MarterLee/switch-power-supply-2017NUEDC/README.md

# switch power supply-2017NUEDC

### 全国大学生电子设计竞赛简介

> 全国大学生电子设计竞赛（National Undergraduate Electronics Design Contest）是[教育部](https://baike.baidu.com/item/教育部)和工业和信息化部共同发起的[大学生](https://baike.baidu.com/item/大学生/1444)学科竞赛之一，是面向大学生的群众性科技活动，目的在于推动高等学校促进信息与电子类学科课程体系和课程内容的改革。竞赛的特点是与高等学校相关专业的[课程体系](https://baike.baidu.com/item/课程体系/3465161)和课程内容改革密切结合，以推动其课程教学、教学改革和实验室建设工作。

竞赛主要分为7个方向：

1. 电源类
2. 信号源类
3. 高频无线电类
4. 放大器类
5. 仪器仪表类
6. 数据采集与处理类
7. 控制类

7个类别分开评测，评奖。其中各全国一等奖的获奖比例小于0.2%。在2017年NUEDC竞赛中，来自全国31个赛区的1,071所大学的43,341名学生参加了本届竞赛，赛制为4天3夜全封闭3人一组独立设计，制作。

## 17国赛电源赛题

### 任务

设计并制作由两个三相逆变器等组成的微电网模拟系统，其系统框图如图 1所示，负载为三相对称 Y 连接电阻负载。



### 要求
