MarterLee/switch-power-supply-2017NUEDC/Schematic/主板原理图.pdf

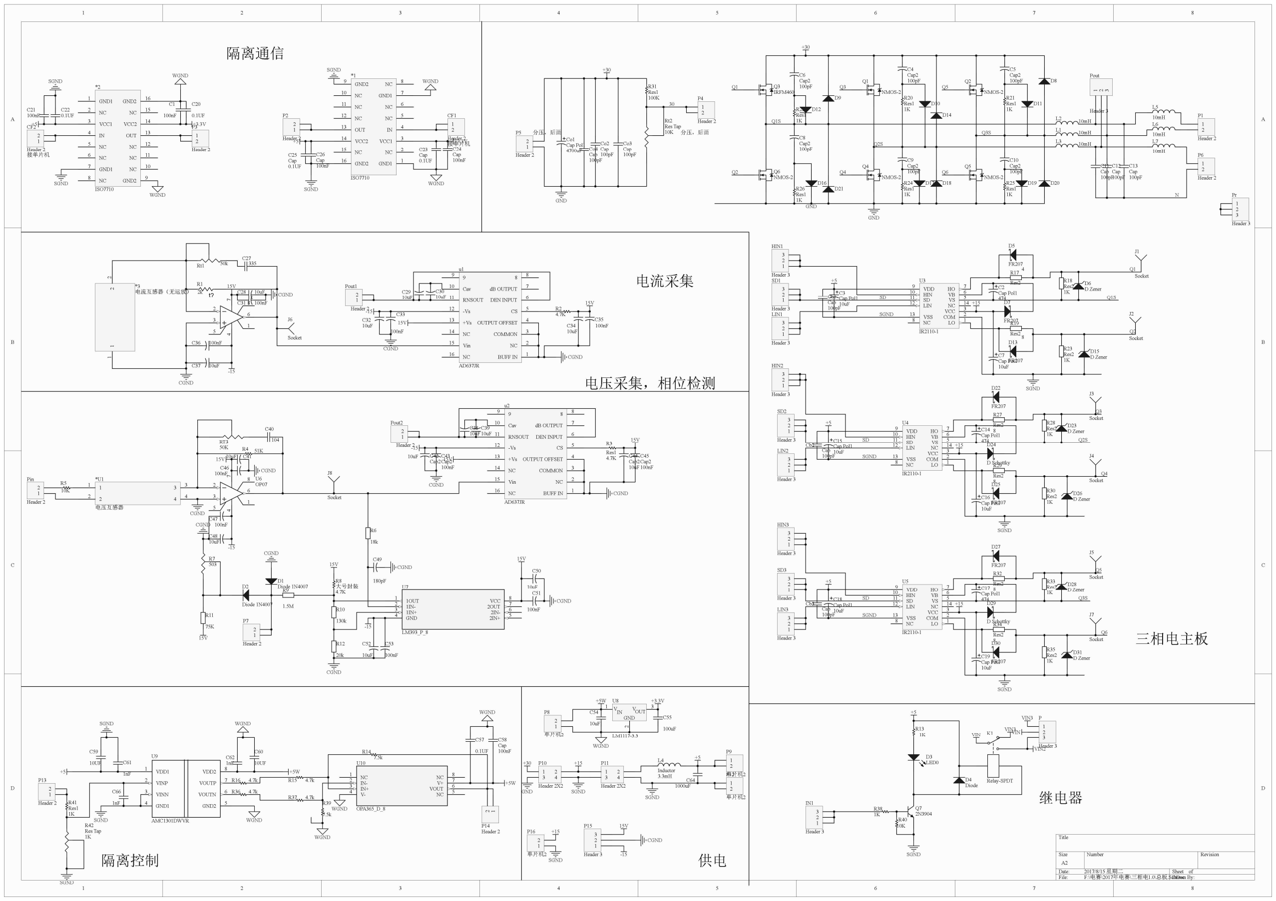
[picture p1: page 1]

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
Title
Size | Number | Revision
A2
Date: | 2017/8/15 星期二 | Sheet of
File: | F:\电赛\2017年电赛\三相电1.0\总板.SchDoc Drawn By:

LO 1

COM 2

VCC 3

VS 5

VB 6

HO 7

NC 8

VDD 9
HIN 10
SD 11
LIN 12
VSS 13

NC 14

U3

IR2110-1

474

C2
Cap Pol1

10uF

C7
Cap Pol1

D13
FR207

D7
FR207

D5
FR207
D6
D Zener

D15
D Zener

4
R17
Res2

8

R19
Res2

1K

R18
Res2

1K

R23
Res2

+15

LO 1

COM 2

VCC 3

VS 5

VB 6

HO 7

NC 8

VDD 9
HIN 10
SD 11
LIN 12
VSS 13

NC 14

U4

IR2110-1

474

C14
Cap Pol1

10uF

C16
Cap Pol1

D25
FR207

D24
D Schottky

D22
FR207
D23
D Zener

D26
D Zener

8

R27
Res2

8

R29
Res2

1K

R28
Res2

1K

R30
Res2

+15

SGND

SGND

SD

SD

SGND

SGND

Q3
IRFM460

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
HIN1

Header 3

1

2

3

SD1

Header 3

1

2

3

LIN1

Header 3

1

2

3

HIN2

Header 3

1

2

3

SD2

Header 3

1

2

3

LIN2

Header 3

10uF

C3
Cap Pol1

10uF

C15
Cap Pol1

GND

1K

R22
Res1

1K

R26
Res1

1K

R20
Res1

1K

R24
Res1

Q4
NMOS-2

Q6
NMOS-2

Q1
NMOS-2

+30

+5

+5

100pF

C6

Cap2 | 100pF C4
| Cap2

100pF

C9
Cap2

100pF

C8
Cap2

D12

D16 | D17 D10

J1

Socket

J2

Socket

J3

Socket

J4

Socket

100pF

Cb2
Cap

100pF

Cb1
Cap

LO 1

COM 2

VCC 3

VS 5

VB 6

HO 7

NC 8

VDD 9
HIN 10
SD 11
LIN 12
VSS 13

NC 14

U5

IR2110-1

474

C17
Cap Pol1

10uF

C19
Cap Pol1

D30
FR207

D29
D Schottky

D27
FR207
D28
D Zener

D31
D Zener

8

R32
Res2

8

R34
Res2

1K

R33
Res2

1K

R35
Res2

+15

SGND

SD
SGND

Q5

Q6

Q3S

1

2

3

HIN3

Header 3

1

2

3

SD3

Header 3

1

2

3

LIN3

Header 3

10uF

C18
Cap Pol1

+5

J5

Socket

J7

Socket

100pF

Cb3
Cap

Q5

Q6

Q3S

1K

R21
Res1

1K

R25
Res1

Q5
NMOS-2

Q2
NMOS-2

100pF

C5
Cap2

100pF

C10
Cap2
D19

D11

D9
D14

D8

D18 | D20
D21

10mH L1

10mH L2

10mH L3

100pF

C11
Cap
100pF

C12
Cap
100pF

C13
Cap

4700uF

Co1
Cap Pol1
100pF

Co2
Cap
100pF

Co3
Cap

100K

R31
Res1

GND

10K 分压，后画

Rt2
Res Tap

+30

1

2

P5

Header 2

分压，后画

30 1
2

P4

Header 2 | 1
| 2

P1

Header 2

1
2

P6

Header 2

2
3

6 4 7 1

8

5

15V

-15 ¹

1

2

2
*3
电流互感器（无运放） | t?

R1
2k

335

C27
50k Rt1

CGND

CGND

1

2

Pout1

Header 2
4.7K

R2

10uF

C30

BUFF IN 1

NC 2

COMMON 3

OUTPUT OFFSET 4

CS 5

DEN INPUT 6

dB OUTPUT 7 Cav 10
RNSOUT 11
-Vs 12
+Vs 13
NC 14
Vin 15
NC 16

8

8
9

9

u1

AD637JR

15V

-15

15V

100nF

C35

C36 100nF

C28 10uF CGND

100nF

C33

CGND

J6
Socket

C37 10uF

C31 100nF

10uF

10uF | C34

C32

10uF

C29

10K

R5

R4 51K

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
电压互感器

2
3

6 4 7 1

8

5

U6
OP07

CGND

104

C40

15V

-15

RT3
50K

-15

4.7K

R8

大号封装

15V

1

2

P7

Header 2

D2
Diode 1N4007 1.5M

R9

75K

R11

503

R7

15V

CGND

D1
Diode 1N4007

CGND

130k

R10

20k

R12

CGND

18k

R6

100nF

C46 CGND

10uF

C52

100nF

C47

J8

Socket

1OUT 1
1IN- 2
1IN+ 3
GND 4

2IN+ 5

2IN- 6

2OUT 7

VCC 8

U7

LM393_P_8

15V

100nF

C51

10uF

C50

CGND

100nF

C53

CGND

1

2

Pout2

Header 2
4.7K

R3
Res1

10uF

C39

BUFF IN 1

NC 2

COMMON 3

OUTPUT OFFSET 4

CS 5

DEN INPUT 6

dB OUTPUT 7 Cav 10
RNSOUT 11
-Vs 12
+Vs 13
NC 14
Vin 15
NC 16

8

8
9

9

u2

AD637JR

15V

-15

15V

100nF

C45
Cap2
100nF

C43
Cap2

CGND

10uF

C44
Cap2

10uF C42
Cap2

10uF

C38

180pF

C49
CGND

10uF

C48

10uF C41

VDD1 1
VINP 2
VINN 3
GND1 4 | GND2 5

VOUTN 6

VOUTP 7

VDD2 8

U9

AMC1301DWVR

NC 1
IN- 2
IN+ 3
V- 4 | NC 5

VOUT 6

V+ 7

NC 8

U10

OPA365_D_8

+5

10UF

C59

1nF

C61

1nF

C66 1

2

P13

Header 2

+5W

10UF

C60
1nF

C62

+5W
R36 4.7k
R16 | 4.7k 4.7k | R15
R37 4.7k
7.5k

R39

7.5k

R14 | 2

1
P14
Header 2

0.1UF

C57

SGND

SGND

WGND

WGND

WGND

100nF

C58
Cap

WGND

WGND

GND1 1
NC 2
VCC1 3
IN 4
NC 5
NC 6
GND1 7
NC 8

NC 10

NC 11

NC 12

OUT 13

VCC2 14

NC 15

GND2 16

GND2 9

*2

ISO7710

+5

0.1UF

C22

SGND

1

2

接单片机

CF2

Header 2

SGND

+3.3V

100nF

C1

WGND

WGND

1
2

P3

Header 2

100nF

C21
0.1UF

C20

GND1 1

NC 2

VCC1 3

IN 4

NC 5

NC 6

GND1 7

NC 8
NC 10
NC 11
NC 12
OUT 13
VCC2 14
NC 15
GND2 16

GND2 9

*1

ISO7710

0.1UF

C23
Cap

1
2

接单片机

CF1

Header 2

100nF

C26
Cap

1

2

P2

Header 2

100nF

C24
Cap
0.1UF

C25
Cap

SGND

SGND
WGND
+5 | +3.3V

WGND

1

2

P8

单片机2

+5W

WGND

1 3 2
V V
GND

IN OUT

U8

LM1117-3.3

10uF

C54
100uF

C55

+3.3V

1 2
3 4

P10

Header 2X2

1 2
3 4

P11

Header 2X2

+30

GND

+15

SGND

3.3mH

L4
Inductor

SGND

1
2

P9

单片机2
1
2

P12

单片机2

1000uF

C64

1

2

3

P15

Header 3

15V
CGND
-15

K1

Relay-SPDT

D3
LED0

1K

R13

+5

SGND

Q7
1K | 2N3904

R38
10K

R40 1

2

3

IN1

Header 3

VIN
VIN2

VIN3

N
1
2
3

Pr

Header 3

隔离通信

### 电流采集

### 电压采集，相位检测

隔离控制 | 供电

1

2

P16

单片机2

+15

SGND

### 三相电主板

继电器

D4
Diode

+5

100pF

Co4
Cap

1
2
3

P

Header 3

1

2

Pin

Header 2

1

2

3

Pout

Header 3
10mH

L5

10mH

L6

10mH

L7

1K

R41
Res1

1K

R42
Res Tap

SGND

VIN

VIN3
