MarterLee/switch-power-supply-2017NUEDC/Schematic/从板-原理图.pdf

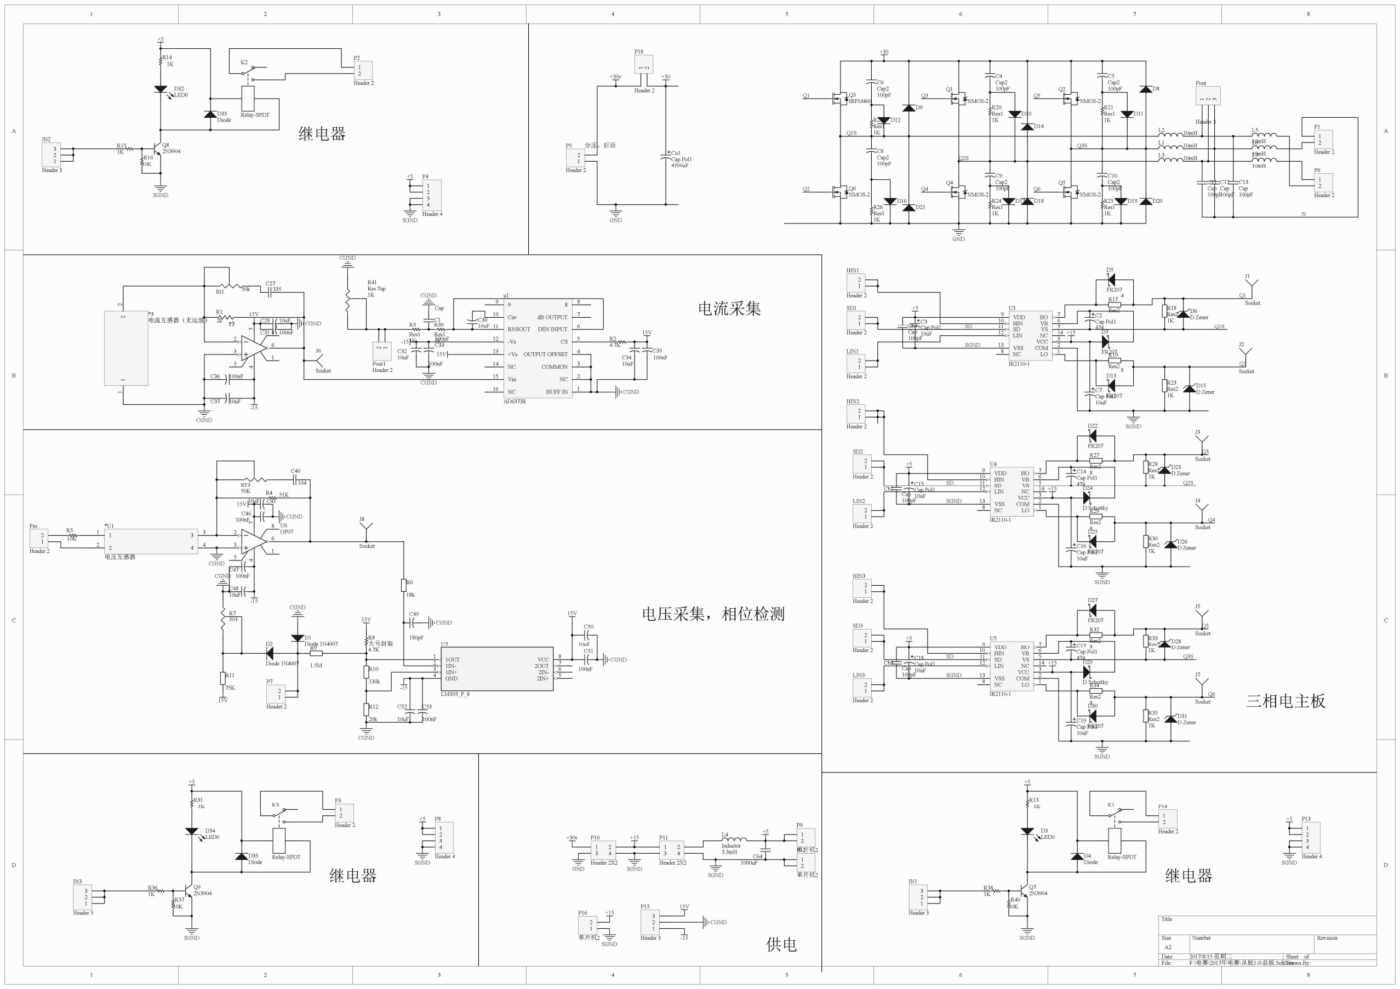
[picture p2: page 1]

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
Title
Size | Number | Revision
A2
Date: | 2017/8/15 星期二 | Sheet of
File: | F:\电赛\2017年电赛\从板1.0\总板.SchDoc Drawn By:

LO 1

COM 2

VCC 3

VS 5

VB 6

HO 7

NC 8

VDD 9
HIN 10
SD 11
LIN 12
VSS 13

NC 14

U3

IR2110-1

474

C2
Cap Pol1

10uF

C7
Cap Pol1

D13
FR207

D7
FR207

D5
FR207
D6
D Zener

D15
D Zener

4
R17
Res2

8

R19
Res2

1K

R18
Res2

1K

R23
Res2

+15

LO 1

COM 2

VCC 3

VS 5

VB 6

HO 7

NC 8

VDD 9
HIN 10
SD 11
LIN 12
VSS 13

NC 14

U4

IR2110-1

474

C14
Cap Pol1

10uF

C16
Cap Pol1

D25
FR207

D24
D Schottky

D22
FR207
D23
D Zener

D26
D Zener

8

R27
Res2

8

R29
Res2

1K

R28
Res2

1K

R30
Res2

+15

SGND

SGND

SD

SD

SGND

SGND

Q3
IRFM460

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
10uF

C3
Cap Pol1

10uF

C15
Cap Pol1

GND

1K

R22
Res1

1K

R26
Res1

1K

R20
Res1

1K

R24
Res1

Q4
NMOS-2

Q6
NMOS-2

Q1
NMOS-2

+30

+5

+5

100pF

C6

Cap2 | 100pF C4
| Cap2

100pF

C9
Cap2

100pF

C8
Cap2

D12

D16 | D17 D10

J1

Socket

J2

Socket

J3

Socket

J4

Socket

100pF

Cb2
Cap

100pF

Cb1
Cap

LO 1

COM 2

VCC 3

VS 5

VB 6

HO 7

NC 8

VDD 9
HIN 10
SD 11
LIN 12
VSS 13

NC 14

U5

IR2110-1

474

C17
Cap Pol1

10uF

C19
Cap Pol1

D30
FR207

D29
D Schottky

D27
FR207
D28
D Zener

D31
D Zener

8

R32
Res2

8

R34
Res2

1K

R33
Res2

1K

R35
Res2

+15

SGND

SD
SGND

Q5

Q6

Q3S
10uF

C18
Cap Pol1

+5

J5

Socket

J7

Socket

100pF

Cb3
Cap

Q5

Q6

Q3S

1K

R21
Res1

1K

R25
Res1

Q5
NMOS-2

Q2
NMOS-2

100pF

C5
Cap2

100pF

C10
Cap2
D19

D11

D9
D14

D8

D18 | D20
D21

10mH L1

10mH L2

10mH L3

100pF

C11
Cap
100pF

C12
Cap
100pF

C13
Cap

4700uF

Co1
Cap Pol1

GND

+30

1

2

P5

Header 2

分压，后画

1
2

P1

Header 2

1
2

P6

Header 2

2
3

6 4 7 1

8

5

15V

-15 ¹

1

2

2
*3
电流互感器（无运放） | t?

R1
2k

335

C27
50k Rt1

CGND

CGND ²

1
Pout1
Header 2

4.7K

R2

10uF

C30

BUFF IN 1

NC 2

COMMON 3

OUTPUT OFFSET 4

CS 5

DEN INPUT 6

dB OUTPUT 7 Cav 10
RNSOUT 11
-Vs 12
+Vs 13
NC 14
Vin 15
NC 16

8

8
9

9

u1

AD637JR

15V

-15

15V

100nF

C35

C36 100nF

C28 10uF CGND

100nF

C33

CGND

J6
Socket

C37 10uF

C31 100nF

10uF

10uF | C34

C32

10K

R5

R4 51K

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
电压互感器

2
3

6 4 7 1

8

5

U6
OP07

CGND

104

C40

15V

-15

RT3
50K

-15

4.7K

R8

大号封装

15V

1

2

P7

Header 2

D2
Diode 1N4007 1.5M

R9

75K

R11

503

R7

15V

CGND

D1
Diode 1N4007

CGND

130k

R10

20k

R12

CGND

18k

R6

100nF

C46 CGND

10uF

C52

100nF

C47

J8

Socket

1OUT 1
1IN- 2
1IN+ 3
GND 4

2IN+ 5

2IN- 6

2OUT 7

VCC 8

U7

LM393_P_8

15V

100nF

C51

10uF

C50

CGND

100nF

C53

180pF

C49
CGND

10uF

C48

10uF C41

1 2
3 4

P10

Header 2X2

1 2
3 4

P11

Header 2X2

+30v

GND

+15

SGND

3.3mH

L4
Inductor

SGND

1
2

P9

单片机2
1
2

P12

单片机2

1000uF

C64

1

2

3

P15

Header 3

15V
CGND
-15

K1

Relay-SPDT

D3
LED0

1K

R13

+5

SGND

Q7
1K | 2N3904

R38
10K

R40 1

2

3

IN1

Header 3

N

### 电流采集

### 电压采集，相位检测

供电

1

2

P16

单片机2

+15

SGND

### 三相电主板

继电器

D4
Diode

+5

1

2

Pin

Header 2

1

2

3

Pout

Header 3
10mH

L5

10mH

L6

10mH

L7

1

2

HIN1

Header 2

1

2

HIN2

Header 2

1

2

HIN3

Header 2

1

2

SD1

Header 2

1

2

SD2

Header 2

1

2

SD3

Header 2

1

2

LIN1

Header 2

1

2

LIN2

Header 2

1

2

LIN3

Header 2

K2

Relay-SPDT

D32
LED0

1K

R14

+5

SGND

Q8
1K | 2N3904

R15
10K

R16 1

2

3

IN2

Header 3

继电器

D33
Diode

K3

Relay-SPDT

D34
LED0

1K

R31

+5

SGND

Q9
1K | 2N3904

R36
10K

R37 1

2

3

IN3

Header 3

继电器

D35
Diode

+5

SGND

1
2

P2

Header 2

1
2

P14

Header 2

1
2

P3

Header 2

1

2

P18

Header 2

1
2
3
4

P8

Header 4

+5

SGND

1
2
3
4

P13

Header 4

+5

SGND

1
2
3
4

P4

Header 4

+30v

1K

R39
Res1
1K

R3
Res1

1K

R41
Res Tap

100pF

C1

Cap

CGND

CGND
