MarterLee/switch-power-supply-2017NUEDC/Doc/figure1.png

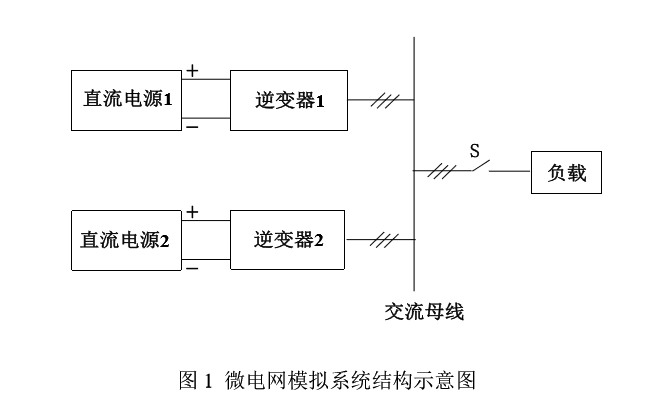
Doc/figure1.png
