MarterLee/switch-power-supply-2017NUEDC/Doc/(新版)MINI-STM32--原理图.pdf

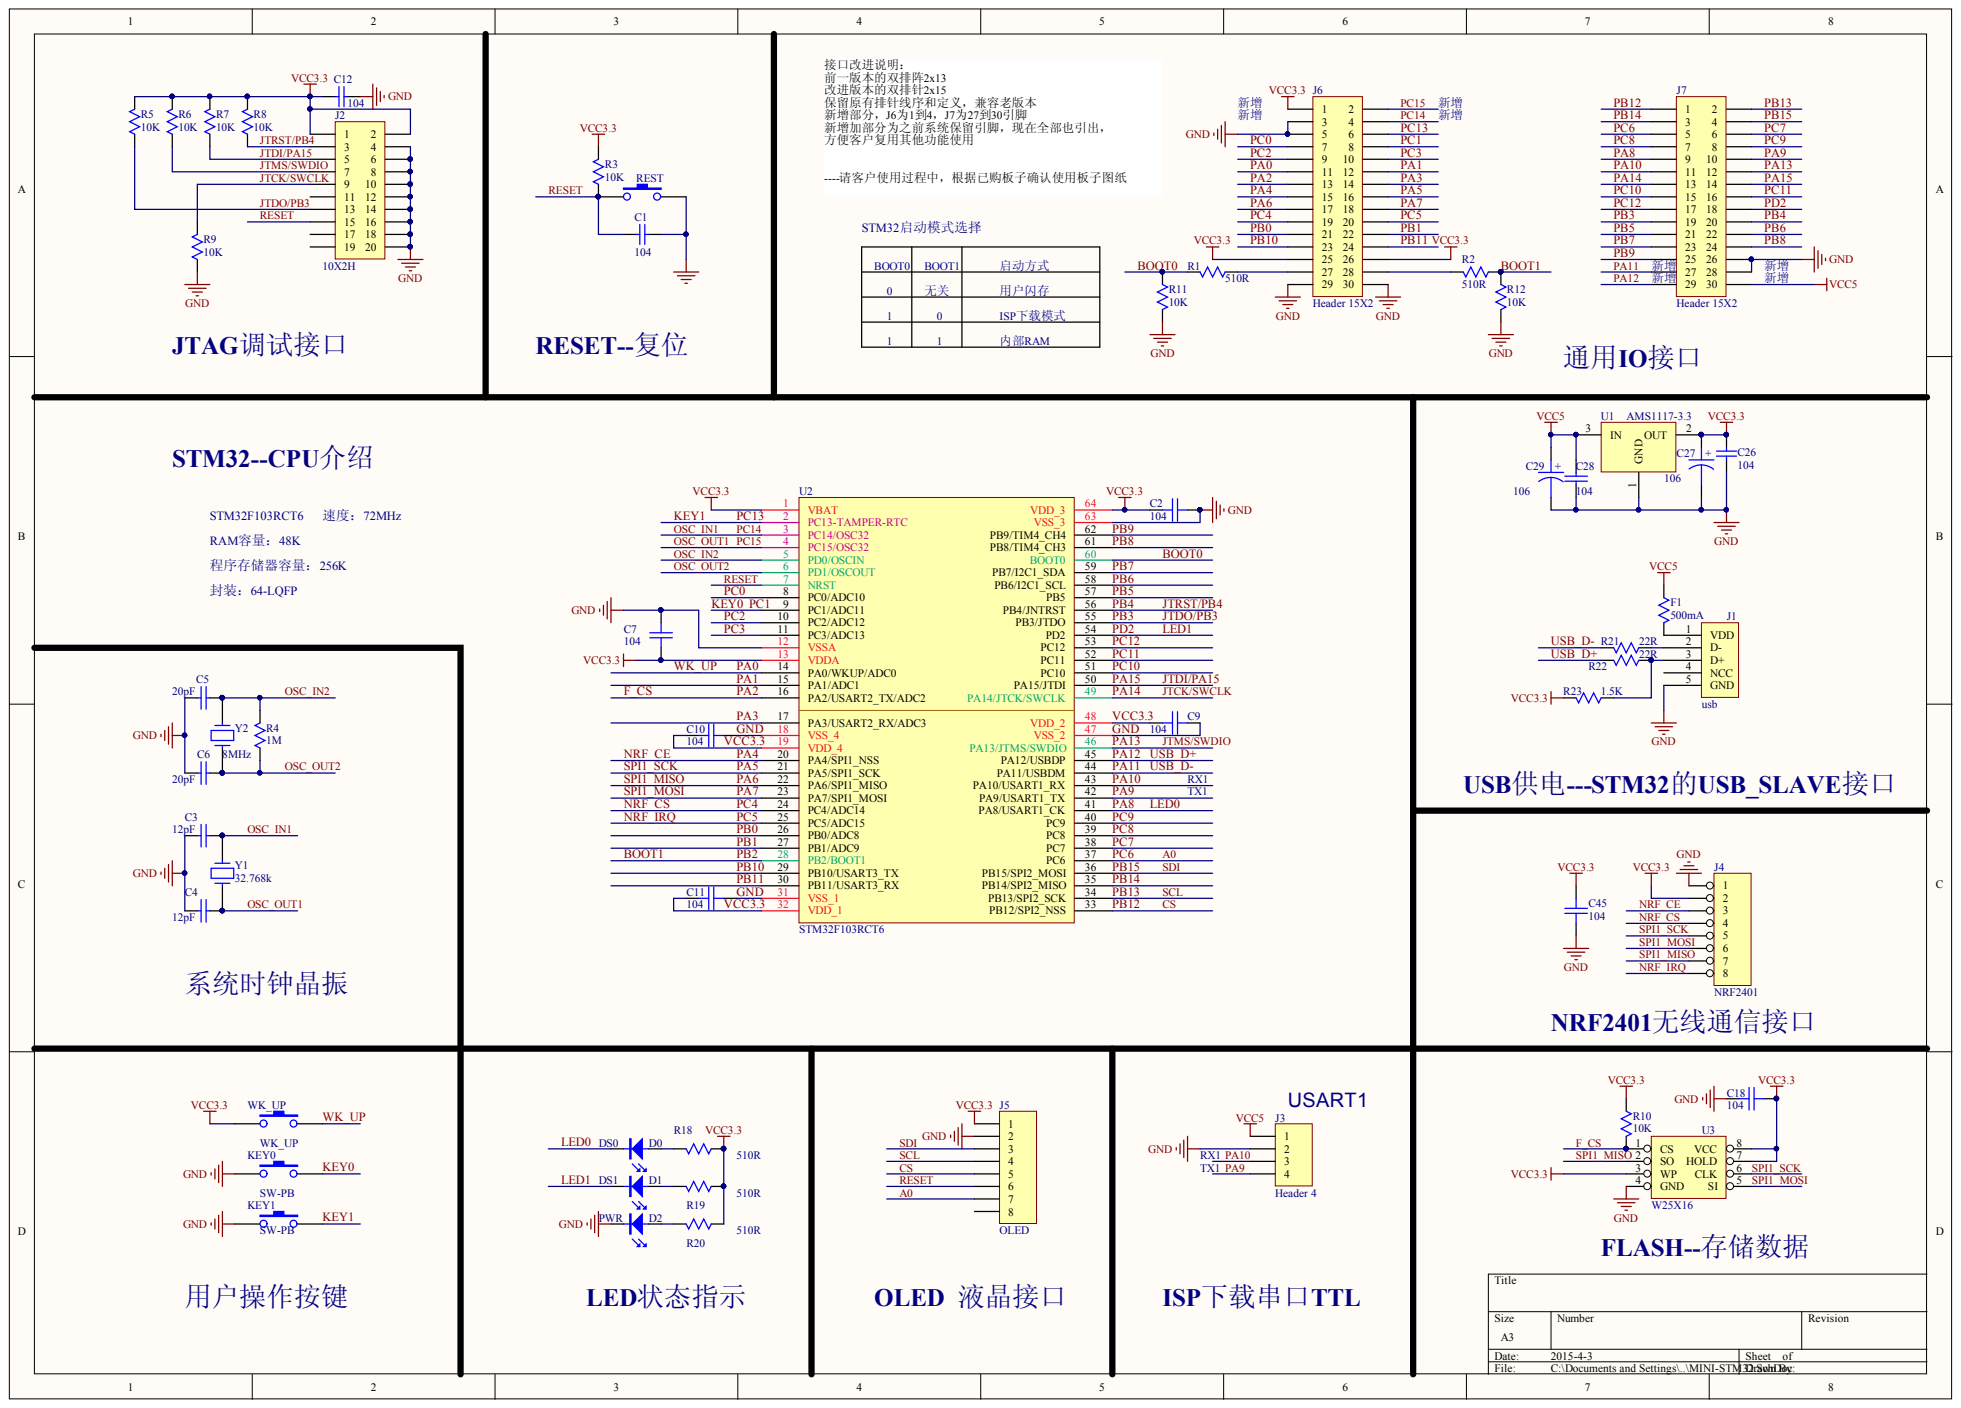
[picture p16: page 1]

JTDO/PB3
RESET

1 | 0 | ISP下载模式

1 | 1 | 内部RAM

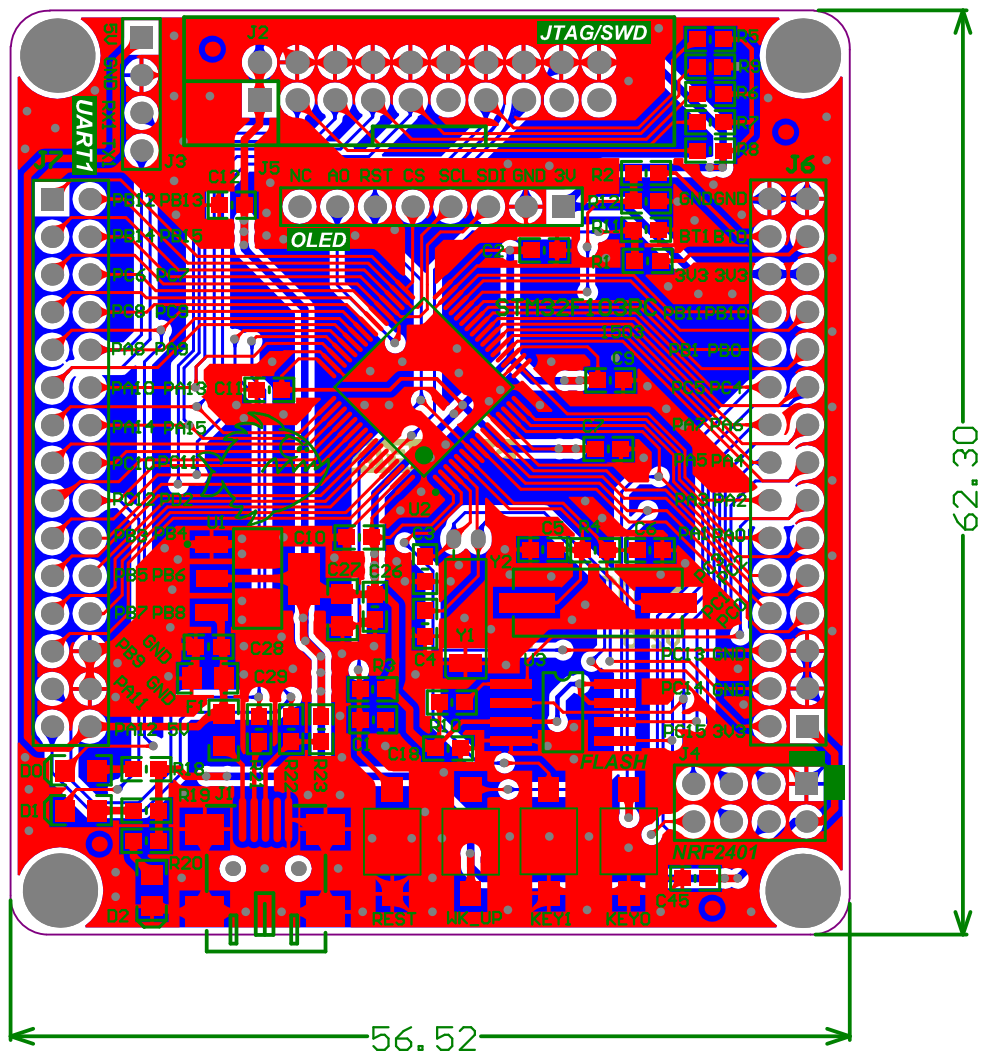
[picture p17: page 2]

Designator | Footprint | Quantity | Comment
C1, C12 | 0603C | 2 | 104
C2, C7, C9, C10, C11, C18, C26, C28, C45 | 0603J | 9 | 104
C3, C4 | 0603J | 2 | 12pF
C5, C6 | 0603J | 2 | 20pF
C27, C29 | RC0805 | 2 | 106
D0 | LED0805 | 1 | DS0
D1 | LED0805 | 1 | DS1
D2 | LED0805 | 1 | PWR
F1 | RC0805 | 1 | 500mA
J1 | mini_USB | 1 | usb
J2 | IDC20 | 1 | 10X2H
J3 | HDR1X4 | 1 | Header 4
J4 | HDR2X4 | 1 | NRF2401
J5 | HDR1X8 | 1 | OLED
J6, J7 | IDE15X2_2.54 | 2 | Header 15X2
KEY0, KEY1 | SW-SPST | 2 | SW-PB
R1, R2, R18, R19, R20 | 0603J | 5 | 510R
R3, R5, R6, R7, R8, R9, R10, R11, R12 | 0603J | 9 | 10K
R4 | 0603J | 1 | 1M
R21, R22 | 0603J | 2 | 22R
R23 | 0603J | 1 | 1.5K
REST | SW-SPST | 1
U1 | SOT223 | 1 | AMS1117-3.3
U2 | LQFP64 | 1 | STM32F103RCT6
U3 | SOIC8P | 1 | W25X16
WK_UP | SW-SPST | 1 | WK_UP
Y1 | 32.768k | 1 | 32.768k
Y2 | smt-xtal | 1 | 8MHz
