MarterLee/switch-power-supply-2017NUEDC/PCBs/主板.pdf

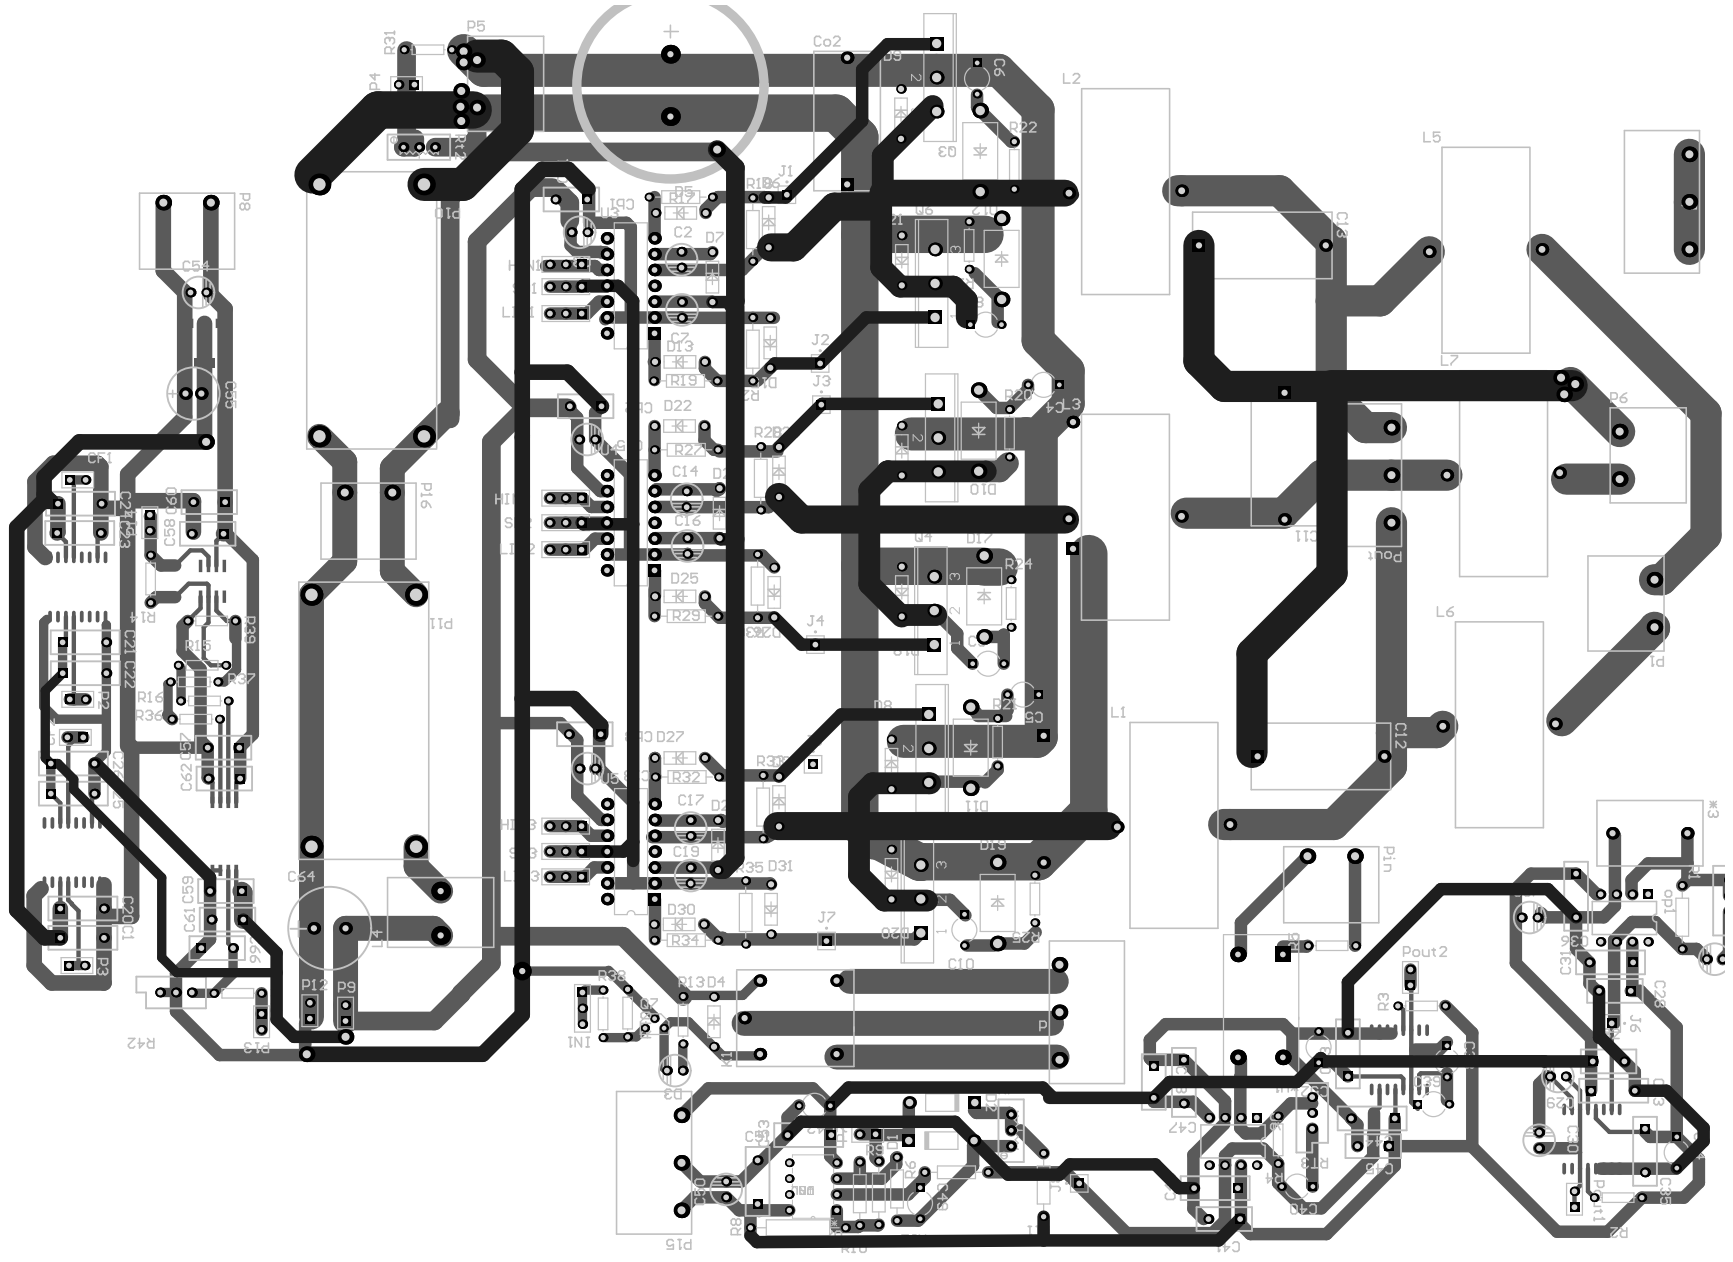
[picture p18: page 1]
