MarterLee/switch-power-supply-2017NUEDC/PCBs/从板.pdf

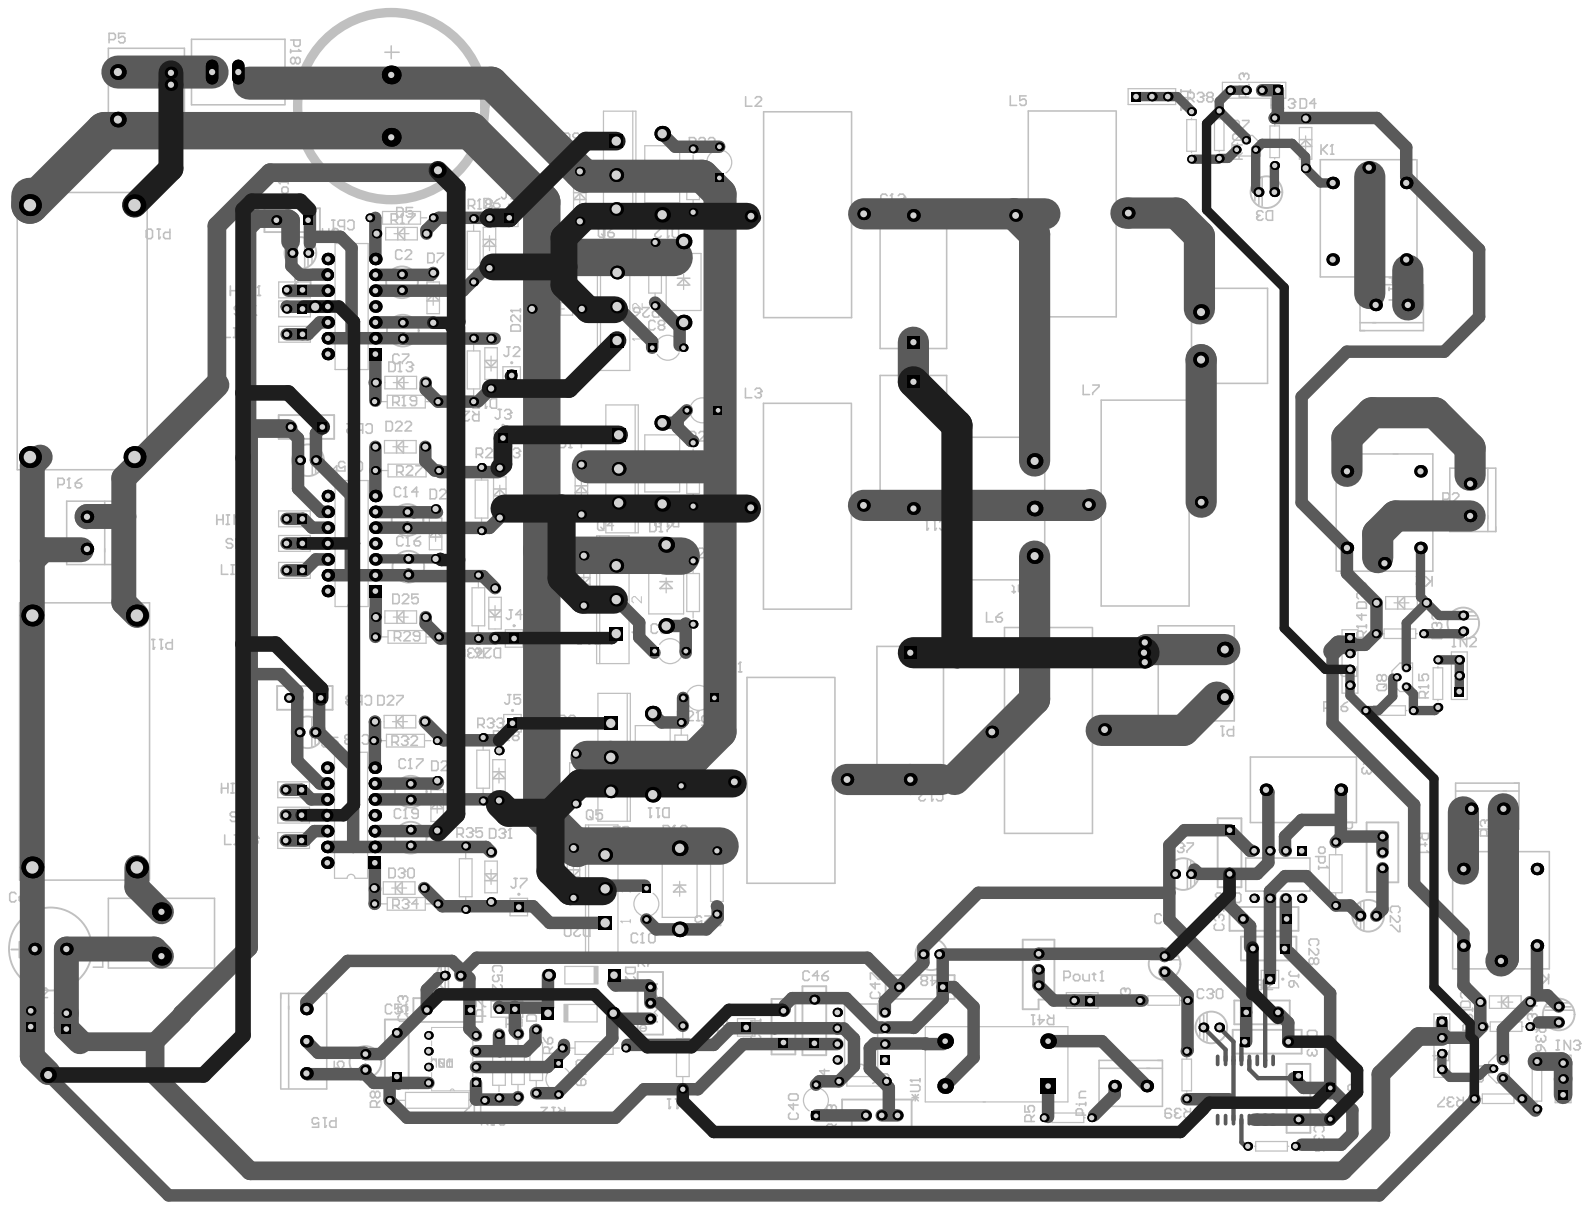
[picture p19: page 1]
