MarterLee/switch-power-supply-2017NUEDC/PCBs/从板1.0b.pdf

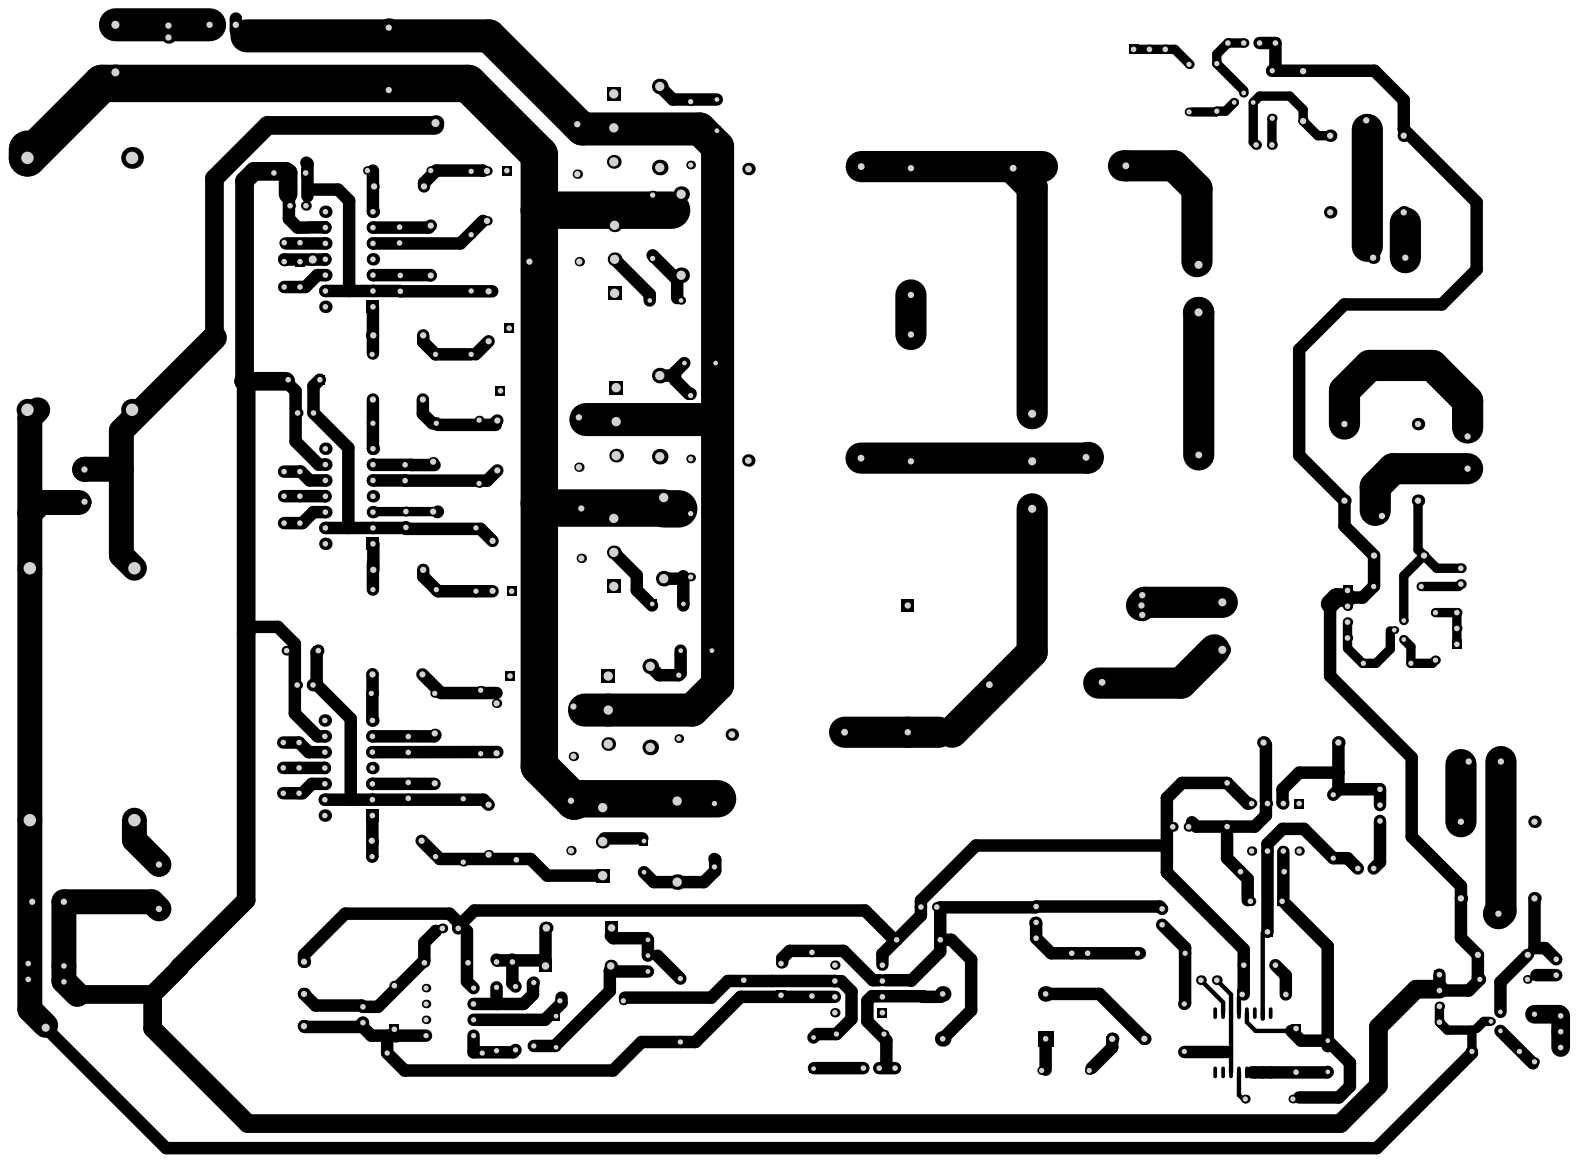
[picture p20: page 1]
