MarterLee/switch-power-supply-2017NUEDC/PCBs/从板1.0t.pdf

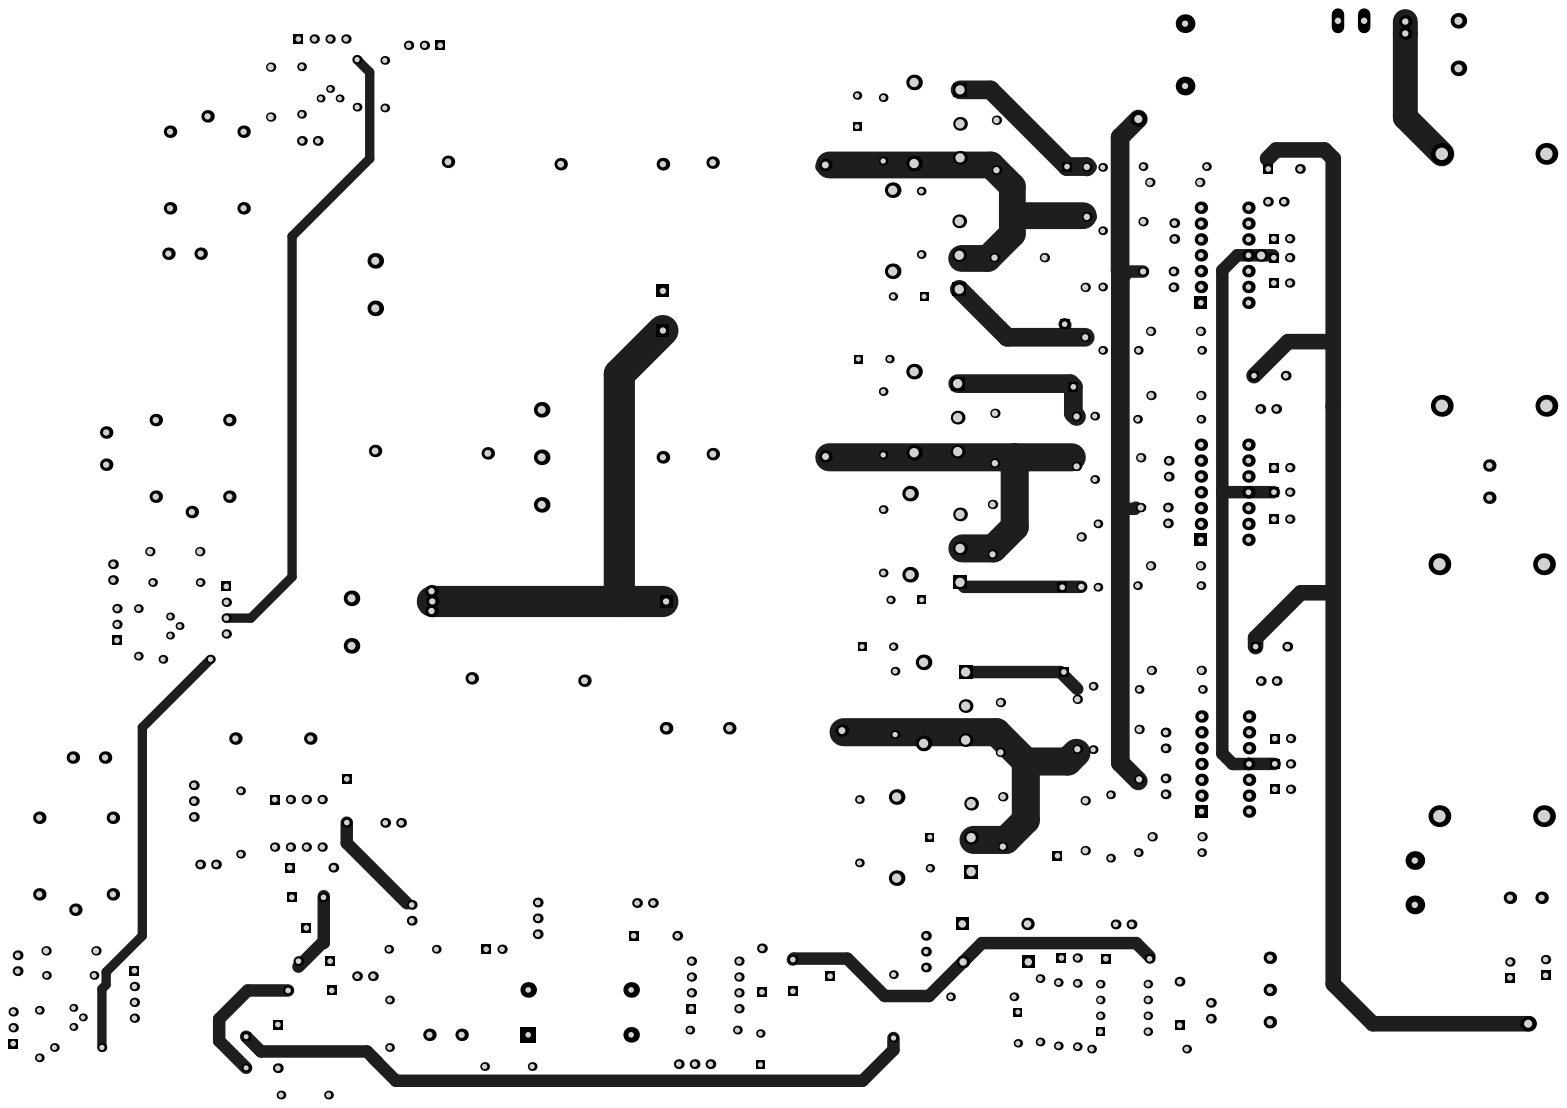
[picture p21: page 1]
