MarterLee/switch-power-supply-2017NUEDC/Code/master side/App/cpwm.c

#include "eval.h"
#include "cpwm.h"
#include "sys.h"
// 互补pwm设置
// TIM1或TIM8
//TIM8 CH1-CH3    PC6 PC7 PC8
//TIM8 CH1N-CH3N  PA7 PB0 PB1
void CPWM_Init(u16 arr,u16 psc)
{  
	GPIO_InitTypeDef GPIO_InitStructure;
	TIM_TimeBaseInitTypeDef  TIM_TimeBaseStructure;
	TIM_OCInitTypeDef  TIM_OCInitStructure;
	TIM_BDTRInitTypeDef TIM_BDTRInitStructure;
	
	RCC_APB2PeriphClockCmd(RCC_APB2Periph_TIM8, ENABLE);//
	RCC_APB2PeriphClockCmd(RCC_APB2Periph_TIM1, ENABLE);//
	//RCC_APB2PeriphClockCmd(RCC_APB2Periph_GPIOA , ENABLE);  //使能GPIO外设时钟使能	
 	RCC_APB2PeriphClockCmd(RCC_APB2Periph_GPIOB , ENABLE);  //使能GPIO外设时钟使能
	RCC_APB2PeriphClockCmd(RCC_APB2Periph_GPIOC , ENABLE);  //使能GPIO外设时钟使能                                                                  	
  RCC_APB2PeriphClockCmd(RCC_APB2Periph_GPIOA , ENABLE);  //使能GPIO外设时钟使能 
  
//   //设置该引脚为复用输出功能,输出TIM1 CH1的PWM脉冲波形
//	GPIO_InitStructure.GPIO_Pin = GPIO_Pin_7;
//	GPIO_InitStructure.GPIO_Mode = GPIO_Mode_AF_PP;  //复用推挽输出
//	GPIO_InitStructure.GPIO_Speed = GPIO_Speed_50MHz;
//	GPIO_Init(GPIOA, &GPIO_InitStructure);
	//GPIO_InitStructure.GPIO_Pin = GPIO_Pin_8|GPIO_Pin_9|GPIO_Pin_10; //TIM_CH1
	GPIO_InitStructure.GPIO_Pin = GPIO_Pin_1|GPIO_Pin_0|GPIO_Pin_14;
	GPIO_InitStructure.GPIO_Mode = GPIO_Mode_AF_PP;  //复用推挽输出
	GPIO_InitStructure.GPIO_Speed = GPIO_Speed_50MHz;
	GPIO_Init(GPIOB, &GPIO_InitStructure);
	//GPIO_InitStructure.GPIO_Pin = GPIO_Pin_13|GPIO_Pin_14|GPIO_Pin_15; //TIM_CH1
	GPIO_InitStructure.GPIO_Pin = GPIO_Pin_8|GPIO_Pin_7;
	GPIO_InitStructure.GPIO_Mode = GPIO_Mode_AF_PP;  //复用推挽输出
	GPIO_InitStructure.GPIO_Speed = GPIO_Speed_50MHz;
	GPIO_Init(GPIOC, &GPIO_InitStructure);
	
	GPIO_InitStructure.GPIO_Pin = GPIO_Pin_9;
	GPIO_InitStructure.GPIO_Mode = GPIO_Mode_AF_PP;  //复用推挽输出
	GPIO_InitStructure.GPIO_Speed = GPIO_Speed_50MHz;
	GPIO_Init(GPIOA, &GPIO_InitStructure);
	
	TIM_TimeBaseStructure.TIM_Period = arr; //设置在下一个更新事件装入活动的自动重装载寄存器周期的值	 80K
	TIM_TimeBaseStructure.TIM_Prescaler =psc; //设置用来作为TIMx时钟频率除数的预分频值  不分频
	TIM_TimeBaseStructure.TIM_ClockDivision = 0; //设置时钟分割:TDTS = Tck_tim
	TIM_TimeBaseStructure.TIM_CounterMode = TIM_CounterMode_Up;  //TIM向上计数模式
	TIM_TimeBaseInit(TIM8, &TIM_TimeBaseStructure); //根据TIM_TimeBaseInitStruct中指定的参数初始化TIMx的时间基数单位
  TIM_TimeBaseInit(TIM1, &TIM_TimeBaseStructure); //根据TIM_TimeBaseInitStruct中指定的参数初始化TIMx
 
	TIM_OCInitStructure.TIM_OCMode = TIM_OCMode_PWM2; //选择定时器模式:TIM脉冲宽度调制模式2
	TIM_OCInitStructure.TIM_OutputState = TIM_OutputState_Enable; //比较输出使能
	TIM_OCInitStructure.TIM_OutputNState = TIM_OutputNState_Enable; //比较输出使能
	TIM_OCInitStructure.TIM_Pulse = 0; //设置待装入捕获比较寄存器的脉冲值
	TIM_OCInitStructure.TIM_OCPolarity = TIM_OCPolarity_High; //输出极性:TIM输出比较极性高
	TIM_OCInitStructure.TIM_OCNPolarity = TIM_OCNPolarity_High; //输出极性:TIM输出比较极性高
	
	TIM_OCInitStructure.TIM_OCIdleState = TIM_OCIdleState_Set;
	TIM_OCInitStructure.TIM_OCNIdleState = TIM_OCIdleState_Reset;
	
	//TIM_OC1Init(TIM8, &TIM_OCInitStructure);  //根据TIM_OCInitStruct中指定的参数初始化外设TIMx
	TIM_OC2Init(TIM8, &TIM_OCInitStructure);  //根据TIM_OCInitStruct中指定的参数初始化外设TIMx
	TIM_OC3Init(TIM8, &TIM_OCInitStructure);  //根据TIM_OCInitStruct中指定的参数初始化外设TIMx
	TIM_OC2Init(TIM1, &TIM_OCInitStructure);  //根据TIM_OCInitStruct中指定的参数初始化外设TIMx
	//siqu/////////////////////////////////////////////////////////////////////////////////////////////////
	TIM_BDTRInitStructure.TIM_OSSRState = TIM_OSSRState_Enable;
	TIM_BDTRInitStructure.TIM_OSSIState = TIM_OSSIState_Enable;
	TIM_BDTRInitStructure.TIM_LOCKLevel = TIM_LOCKLevel_OFF;
	//bit7~5 = 111,则deadtime = (32 + (bit4~bit0)* 16*1/fosc)ns = (32+31)*16*1/72000000 = 14us
	TIM_BDTRInitStructure.TIM_DeadTime = 0x25; //这里调整死区大小0-0xff	    死区最大14us
	TIM_BDTRInitStructure.TIM_Break = TIM_Break_Disable;
	TIM_BDTRInitStructure.TIM_BreakPolarity = TIM_BreakPolarity_High;
	TIM_BDTRInitStructure.TIM_AutomaticOutput = TIM_AutomaticOutput_Enable;
	TIM_BDTRConfig(TIM8, &TIM_BDTRInitStructure);
	TIM_BDTRConfig(TIM1, &TIM_BDTRInitStructure);
	////////////////////////////////////////////////////////////////////////////////////////////
	
	
	TIM_CtrlPWMOutputs(TIM8,ENABLE);	//MOE 主输出使能	
  TIM_CtrlPWMOutputs(TIM1,ENABLE);	//MOE 主输出使能	
	
	TIM_OC2PreloadConfig(TIM8, TIM_OCPreload_Enable);  //CH2预装载使能	 
	TIM_OC3PreloadConfig(TIM8, TIM_OCPreload_Enable);  //CH3预装载使能
	TIM_OC2PreloadConfig(TIM1, TIM_OCPreload_Enable);  //CH3预装载使能
	TIM_ARRPreloadConfig(TIM8, ENABLE); //使能TIMx在ARR上的预装载寄存器
	TIM_ARRPreloadConfig(TIM1, ENABLE); //使能TIMx在ARR上的预装载寄存器
	TIM_Cmd(TIM8, ENABLE);  //使能TIM1
	TIM_Cmd(TIM1, ENABLE);  //使能TIM1
	
	TIM8->CNT=0;    //计数器清零 //保持同相位
	TIM1->CNT=10;    //消除指令执行误差时间
}
//通用定时器中断初始化
//这里时钟选择为APB1的2倍，而APB1为36M
//arr：自动重装值。
//psc：时钟预分频数
//这里使用的是定时器3!
void Timer3_Init(u16 arr,u16 psc)
{
    TIM_TimeBaseInitTypeDef  TIM_TimeBaseStructure;
	NVIC_InitTypeDef NVIC_InitStructure;

	RCC_APB1PeriphClockCmd(RCC_APB1Periph_TIM3, ENABLE); //时钟使能

	//TIM_TimeBaseStructure.TIM_Period = 5000; //设置在下一个更新事件装入活动的自动重装载寄存器周期的值	 计数到5000为500ms
	//TIM_TimeBaseStructure.TIM_Prescaler =(7200-1); //设置用来作为TIMx时钟频率除数的预分频值  10Khz的计数频率  
	TIM_TimeBaseStructure.TIM_Period = arr; //设置在下一个更新事件装入活动的自动重装载寄存器周期的值	 计数到5000为500ms
	TIM_TimeBaseStructure.TIM_Prescaler =psc; //设置用来作为TIMx时钟频率除数的预分频值  10Khz的计数频率 
	TIM_TimeBaseStructure.TIM_ClockDivision = 0; //设置时钟分割:TDTS = Tck_tim
	TIM_TimeBaseStructure.TIM_CounterMode = TIM_CounterMode_Up;  //TIM向上计数模式
	TIM_TimeBaseInit(TIM3, &TIM_TimeBaseStructure); //根据TIM_TimeBaseInitStruct中指定的参数初始化TIMx的时间基数单位
 
	TIM_ITConfig(  //使能或者失能指定的TIM中断
		TIM3, //TIM3
		TIM_IT_Update  |  //TIM 中断源
		TIM_IT_Trigger,   //TIM 触发中断源 
		ENABLE  //使能
		);
	NVIC_InitStructure.NVIC_IRQChannel = TIM3_IRQn;  //TIM3中断
	NVIC_InitStructure.NVIC_IRQChannelPreemptionPriority = 3;  //先占优先级0级
	NVIC_InitStructure.NVIC_IRQChannelSubPriority = 4;  //从优先级3级
	NVIC_InitStructure.NVIC_IRQChannelCmd = ENABLE; //IRQ通道被使能
	NVIC_Init(&NVIC_InitStructure);  //根据NVIC_InitStruct中指定的参数初始化外设NVIC寄存器

	TIM_Cmd(TIM3, ENABLE);  //使能TIMx外设
							 
}

//void TIM3_IRQHandler(void)   //TIM3中断
//{
//	if (TIM_GetITStatus(TIM3, TIM_IT_Update) != RESET) //检查指定的TIM中断发生与否:TIM 中断源 
//		{
//		TIM_ClearITPendingBit(TIM3, TIM_IT_Update  );  //清除TIMx的中断待处理位:TIM 中断源 
//			//这里输入中断执行函数化函数
//		
//		}
//}
	void Timer2_Init(u16 arr,u16 psc)
{
    TIM_TimeBaseInitTypeDef  TIM_TimeBaseStructure;
	NVIC_InitTypeDef NVIC_InitStructure;

	RCC_APB1PeriphClockCmd(RCC_APB1Periph_TIM2, ENABLE); //时钟使能

	//TIM_TimeBaseStructure.TIM_Period = 5000; //设置在下一个更新事件装入活动的自动重装载寄存器周期的值	 计数到5000为500ms
	//TIM_TimeBaseStructure.TIM_Prescaler =(7200-1); //设置用来作为TIMx时钟频率除数的预分频值  10Khz的计数频率  
	TIM_TimeBaseStructure.TIM_Period = arr; //设置在下一个更新事件装入活动的自动重装载寄存器周期的值	 计数到5000为500ms
	TIM_TimeBaseStructure.TIM_Prescaler =psc; //设置用来作为TIMx时钟频率除数的预分频值  10Khz的计数频率 
	TIM_TimeBaseStructure.TIM_ClockDivision = 0; //设置时钟分割:TDTS = Tck_tim
	TIM_TimeBaseStructure.TIM_CounterMode = TIM_CounterMode_Up;  //TIM向上计数模式
	TIM_TimeBaseInit(TIM2, &TIM_TimeBaseStructure); //根据TIM_TimeBaseInitStruct中指定的参数初始化TIMx的时间基数单位
 
	TIM_ITConfig(  //使能或者失能指定的TIM中断
		TIM2, //TIM2
		TIM_IT_Update  |  //TIM 中断源
		TIM_IT_Trigger,   //TIM 触发中断源 
		ENABLE  //使能
		);
	NVIC_InitStructure.NVIC_IRQChannel = TIM2_IRQn;  //TIM3中断
	NVIC_InitStructure.NVIC_IRQChannelPreemptionPriority = 0;  //先占优先级0级
	NVIC_InitStructure.NVIC_IRQChannelSubPriority = 0;  //从优先级3级
	NVIC_InitStructure.NVIC_IRQChannelCmd = ENABLE; //IRQ通道被使能
	NVIC_Init(&NVIC_InitStructure);  //根据NVIC_InitStruct中指定的参数初始化外设NVIC寄存器

	TIM_Cmd(TIM2, ENABLE);  //使能TIMx外设
							 
}
void Timer5_Init(u16 arr,u16 psc)
{
    TIM_TimeBaseInitTypeDef  TIM_TimeBaseStructure;
	NVIC_InitTypeDef NVIC_InitStructure;

	RCC_APB1PeriphClockCmd(RCC_APB1Periph_TIM5, ENABLE); //时钟使能

	//TIM_TimeBaseStructure.TIM_Period = 5000; //设置在下一个更新事件装入活动的自动重装载寄存器周期的值	 计数到5000为500ms
	//TIM_TimeBaseStructure.TIM_Prescaler =(7200-1); //设置用来作为TIMx时钟频率除数的预分频值  10Khz的计数频率  
	TIM_TimeBaseStructure.TIM_Period = arr; //设置在下一个更新事件装入活动的自动重装载寄存器周期的值	 计数到5000为500ms
	TIM_TimeBaseStructure.TIM_Prescaler =psc; //设置用来作为TIMx时钟频率除数的预分频值  10Khz的计数频率 
	TIM_TimeBaseStructure.TIM_ClockDivision = 0; //设置时钟分割:TDTS = Tck_tim
	TIM_TimeBaseStructure.TIM_CounterMode = TIM_CounterMode_Up;  //TIM向上计数模式
	TIM_TimeBaseInit(TIM5, &TIM_TimeBaseStructure); //根据TIM_TimeBaseInitStruct中指定的参数初始化TIMx的时间基数单位
 
	TIM_ITConfig(  //使能或者失能指定的TIM中断
		TIM5, //TIM2
		TIM_IT_Update  |  //TIM 中断源
		TIM_IT_Trigger,   //TIM 触发中断源 
		ENABLE  //使能
		);
	NVIC_InitStructure.NVIC_IRQChannel = TIM5_IRQn;  //TIM3中断
	NVIC_InitStructure.NVIC_IRQChannelPreemptionPriority = 3;  //先占优先级0级
	NVIC_InitStructure.NVIC_IRQChannelSubPriority = 0;  //从优先级3级
	NVIC_InitStructure.NVIC_IRQChannelCmd = ENABLE; //IRQ通道被使能
	NVIC_Init(&NVIC_InitStructure);  //根据NVIC_InitStruct中指定的参数初始化外设NVIC寄存器

	TIM_Cmd(TIM5, ENABLE);  //使能TIMx外设
							 
}
//////////////////////////////////////////////////////////////////////////////////	 
//本程序只供学习使用，未经作者许可，不得用于其它任何用途
//ALIENTEK Mini STM32开发板
//系统时钟初始化		   
//正点原子@ALIENTEK
//技术论坛:www.openedv.com
//修改日期:2010/5/27
//版本：V1.4
//版权所有，盗版必究。
//Copyright(C) 正点原子 2009-2019
//All rights reserved
//********************************************************************************  

void NVIC_Configuration(void)
{

    NVIC_PriorityGroupConfig(NVIC_PriorityGroup_2);	//设置NVIC中断分组2:2位抢占优先级，2位响应优先级

}
