MarterLee/switch-power-supply-2017NUEDC/Code/master side/Hardware/LCD/lcd.h

#ifndef __LCD_H
#define __LCD_H		
#include "sys.h"	 
#include "stdlib.h"

//////////////////////////////////////////////////////////////////////////////////	
/****************************************************************************************************
//=======================================液晶屏数据线接线==========================================//
//CS		接PB11	//片选信号
//CLK	    接PB13	//SPI时钟信号
//SDI(DIN)	接PB15	//SPI总线数据信号
//=======================================液晶屏控制线接线==========================================//
//LED	    接PB9	//背光控制信号，高电平点亮
//RS(D/C)   接PB10	//寄存器/数据选择信号(RS=0数据总线发送的是指令；RS=1数据总线发送的是像素数据)
//RST	    接PB12	//液晶屏复位信号，低电平复位
/////////////////////////////////////////////////////////////////////////////////////////////////
//==================================如何精简到只需要3个IO=======================================//
//1.CS信号可以精简，不作SPI复用片选可将CS接地常低，节省1个IO
//2.LED背光控制信号可以接高电平3.3V背光常亮，节省1个IO
//3.RST复位信号可以接到单片机的复位端，利用系统上电复位，节省1个IO
//==================================如何切换横竖屏显示=======================================//
//打开lcd.h头文件，修改宏#define USE_HORIZONTAL 值为0使用竖屏模式.1,使用横屏模式
//===========================如何切换模拟SPI总线驱动和硬件SPI总线驱动=========================//
//打开lcd.h头文件，修改宏#define USE_HARDWARE_SPI  值为0使用模拟SPI总线.1,使用硬件SPI总线
**************************************************************************************************/	

//LCD重要参数集
typedef struct  
{										    
	u16 width;			//LCD 宽度
	u16 height;			//LCD 高度
	u16 id;				//LCD ID
	u8  dir;			//横屏还是竖屏控制：0，竖屏；1，横屏。	
	u16	 wramcmd;		//开始写gram指令
	u16  setxcmd;		//设置x坐标指令
	u16  setycmd;		//设置y坐标指令	 
}_lcd_dev; 	

//LCD参数
extern _lcd_dev lcddev;	//管理LCD重要参数
/////////////////////////////////////用户配置区///////////////////////////////////	 
//支持横竖屏快速定义切换，支持8/16位模式切换
#define USE_HORIZONTAL  	0	//定义是否使用横屏 		0,不使用.1,使用.
//使用硬件SPI 还是模拟SPI作为测试
#define USE_HARDWARE_SPI    0   //1:Enable Hardware SPI;0:USE Soft SPI
//////////////////////////////////////////////////////////////////////////////////	  
//定义LCD的尺寸
#if USE_HORIZONTAL==1	//使用横屏
#define LCD_W 320
#define LCD_H 240
#else
#define LCD_W 240
#define LCD_H 320
#endif

//TFTLCD部分外要调用的函数		   
extern u16  POINT_COLOR;//默认红色    
extern u16  BACK_COLOR; //背景颜色.默认为白色

////////////////////////////////////////////////////////////////////
//-----------------LCD端口定义---------------- 
//模块采用了三极管控制背光亮灭，用户也可以接PWM调节背光亮度
//#define LCD_LED        	GPIO_Pin_9  //PB9 连接至TFT -LED
//接口定义在Lcd_Driver.h内定义，请根据接线修改并修改相应IO初始化LCD_GPIO_Init()
#define LCD_CTRL   	  	GPIOB		//定义TFT数据端口
#define LCD_CTRL2   	  	GPIOC		//定义TFT数据端口
#define LCD_RS         	GPIO_Pin_6	//PB1连接至TFT --RS
#define LCD_CS        	GPIO_Pin_12 //PB11 连接至TFT --CS
//#define LCD_RST     	  GPIO_Pin_12	//PB12连接至TFT --RST
#define LCD_SCL        	GPIO_Pin_13	//PB13连接至TFT -- CLK
#define LCD_SDA        	GPIO_Pin_15	//PB15连接至TFT - SDI
							    
//////////////////////////////////////////////////////////////////////
//液晶控制口置1操作语句宏定义
#define	LCD_CS_SET  	LCD_CTRL->BSRR=LCD_CS    
#define	LCD_RS_SET  	LCD_CTRL2->BSRR=LCD_RS    
#define	LCD_SDA_SET  	LCD_CTRL->BSRR=LCD_SDA    
#define	LCD_SCL_SET  	LCD_CTRL->BSRR=LCD_SCL    
#define	LCD_RST_SET  	LCD_CTRL->BSRR=LCD_RST    
#define	LCD_LED_SET  	LCD_CTRL->BSRR=LCD_LED   

//液晶控制口置0操作语句宏定义
#define	LCD_CS_CLR  	LCD_CTRL->BRR=LCD_CS    
#define	LCD_RS_CLR  	LCD_CTRL2->BRR=LCD_RS    
#define	LCD_SDA_CLR  	LCD_CTRL->BRR=LCD_SDA    
#define	LCD_SCL_CLR  	LCD_CTRL->BRR=LCD_SCL    
#define	LCD_RST_CLR  	LCD_CTRL->BRR=LCD_RST    
#define	LCD_LED_CLR  	LCD_CTRL->BRR=LCD_LED 

//画笔颜色
#define WHITE       0xFFFF
#define BLACK      	0x0000	  
#define BLUE       	0x001F  
#define BRED        0XF81F
#define GRED 			 	0XFFE0
#define GBLUE			 	0X07FF
#define RED         0xF800
#define MAGENTA     0xF81F
#define GREEN       0x07E0
#define CYAN        0x7FFF
#define YELLOW      0xFFE0
#define BROWN 			0XBC40 //棕色
#define BRRED 			0XFC07 //棕红色
#define GRAY  			0X8430 //灰色
//GUI颜色

#define DARKBLUE      	 0X01CF	//深蓝色
#define LIGHTBLUE      	 0X7D7C	//浅蓝色  
#define GRAYBLUE       	 0X5458 //灰蓝色
//以上三色为PANEL的颜色 
 
#define LIGHTGREEN     	0X841F //浅绿色
//#define LIGHTGRAY     0XEF5B //浅灰色(PANNEL)
#define LGRAY 			 		0XC618 //浅灰色(PANNEL),窗体背景色

#define LGRAYBLUE      	0XA651 //浅灰蓝色(中间层颜色)
#define LBBLUE          0X2B12 //浅棕蓝色(选择条目的反色)
	    															  
extern u16 BACK_COLOR, POINT_COLOR ;  

void LCD_Init(void);
void LCD_DisplayOn(void);
void LCD_DisplayOff(void);
void LCD_Clear(u16 Color);	 
void LCD_SetCursor(u16 Xpos, u16 Ypos);
void LCD_DrawPoint(u16 x,u16 y);//画点
u16  LCD_ReadPoint(u16 x,u16 y); //读点
void LCD_DrawLine(u16 x1, u16 y1, u16 x2, u16 y2);
void LCD_DrawRectangle(u16 x1, u16 y1, u16 x2, u16 y2);		   
void LCD_SetWindows(u16 xStar, u16 yStar,u16 xEnd,u16 yEnd);
void LCD_DrawPoint_16Bit(u16 color);
u16 LCD_RD_DATA(void);//读取LCD数据									    
void LCD_WriteReg(u16 LCD_Reg, u16 LCD_RegValue);
void LCD_WR_DATA(u8 data);
void LCD_WR_DATA_16Bit(u16 data);
u16 LCD_ReadReg(u8 LCD_Reg);
void LCD_WriteRAM_Prepare(void);
void LCD_WriteRAM(u16 RGB_Code);
u16 LCD_ReadRAM(void);		   
u16 LCD_BGR2RGB(u16 c);
void LCD_SetParam(void);

						  		 
#endif  
	 
	 
