MarterLee/switch-power-supply-2017NUEDC/Code/master side/App/usart2.h

#ifndef __USART2_H
#define __USART2_H	 
#include "sys.h"  
//////////////////////////////////////////////////////////////////////////////////	 
//本程序只供学习使用，未经作者许可，不得用于其它任何用途
//ALIENTEK STM32开发板
//串口2驱动代码	   
//正点原子@ALIENTEK
//技术论坛:www.openedv.com
//修改日期:2014/3/29
//版本：V1.0
//版权所有，盗版必究。
//Copyright(C) 广州市星翼电子科技有限公司 2009-2019
//All rights reserved									  
////////////////////////////////////////////////////////////////////////////////// 	   

#define USART2_MAX_RECV_LEN		1024				//最大接收缓存字节数
#define USART2_MAX_SEND_LEN		1024				//最大发送缓存字节数
#define USART2_RX_EN 			1					//0,不接收;1,接收.

extern u8  USART2_RX_BUF[USART2_MAX_RECV_LEN]; 		//接收缓冲,最大USART2_MAX_RECV_LEN字节
extern u8  USART2_TX_BUF[USART2_MAX_SEND_LEN]; 		//发送缓冲,最大USART2_MAX_SEND_LEN字节
extern u16 USART2_RX_STA;   						//接收数据状态

void USART2_Init(u32 bound);				//串口2初始化 
void TIM5_Set(u8 sta);
void TIM5_Init(u16 arr,u16 psc);
void UART_DMA_Config(DMA_Channel_TypeDef*DMA_CHx,u32 cpar,u32 cmar);
void UART_DMA_Enable(DMA_Channel_TypeDef*DMA_CHx,u8 len);
void u2_printf(char* fmt, ...);
#endif
