MarterLee/switch-power-supply-2017NUEDC/(notices)

Notices in the files:
Code/slave side/App/common.c:
Copyright(C) ¹ãÖÝÊÐÐÇÒíµç×Ó¿Æ¼¼ÓÐÏÞ¹«Ë¾ 2009-2019
All rights reserved
Code/slave side/SYSTEM/usart/usart.h:
Copyright(C) ÕýµãÔ­×Ó 2009-2019
